Kadam-Yash-Sachin/Pick-and-Place-Arm-Designs/Design implementation images/first_prototype1.jpg

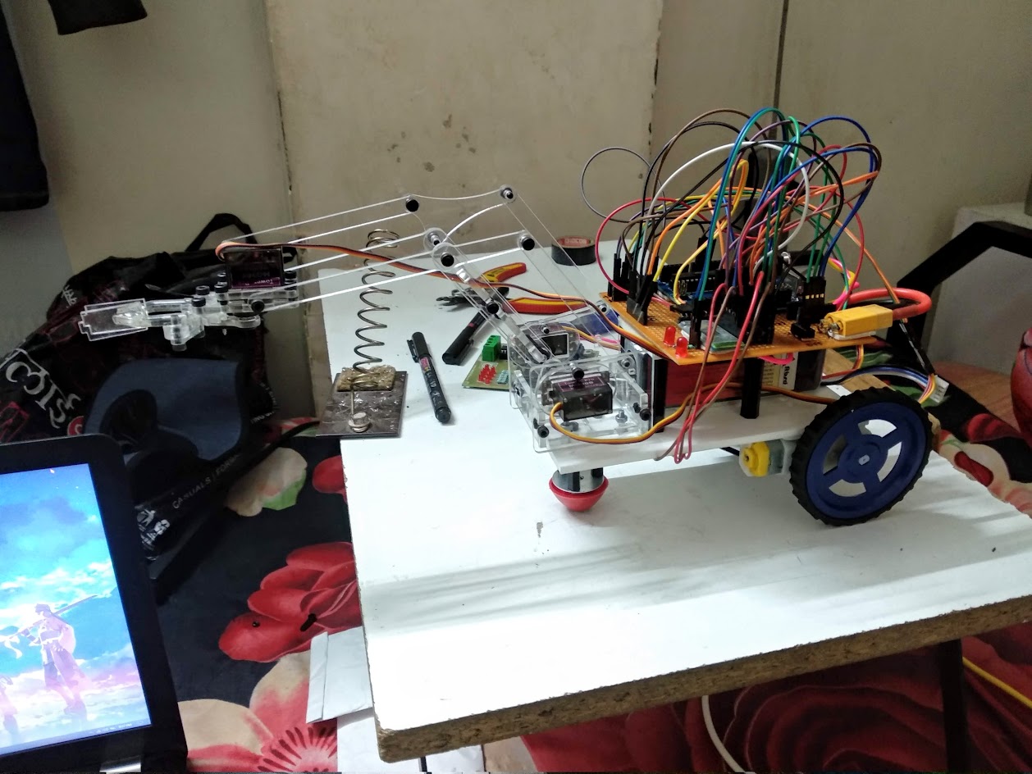
Design implementation images/first_prototype1.jpg
