Kadam-Yash-Sachin/Pick-and-Place-Arm-Designs/Design implementation images/first_prototype.jpg

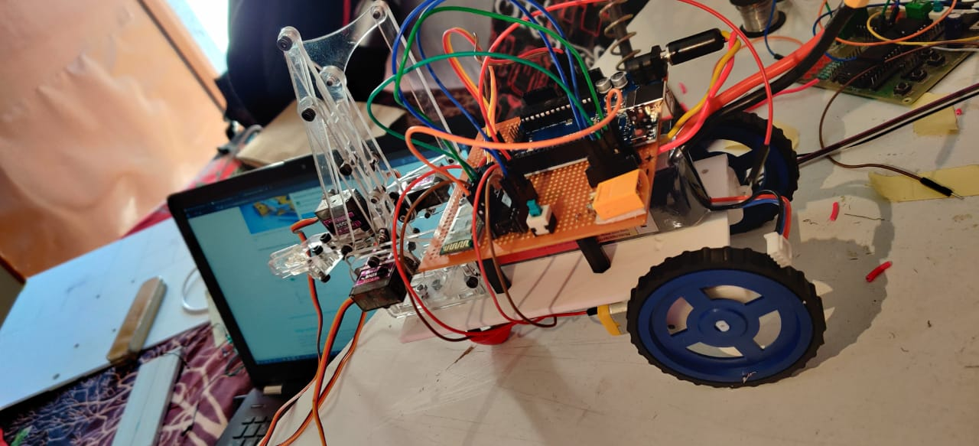
Design implementation images/first_prototype.jpg
