Kadam-Yash-Sachin/Pick-and-Place-Arm-Designs/README.md

# Pick-and-Place-Arm-Designs
Various Pick and Place arms were designed and implemented and were remotely controlled using Arduino and HC-05 Bluetooth Module
