Kadam-Yash-Sachin/Pick-and-Place-Arm-Designs/Design implementation images/Buck_converter_LTspice_sim_SS.jpg

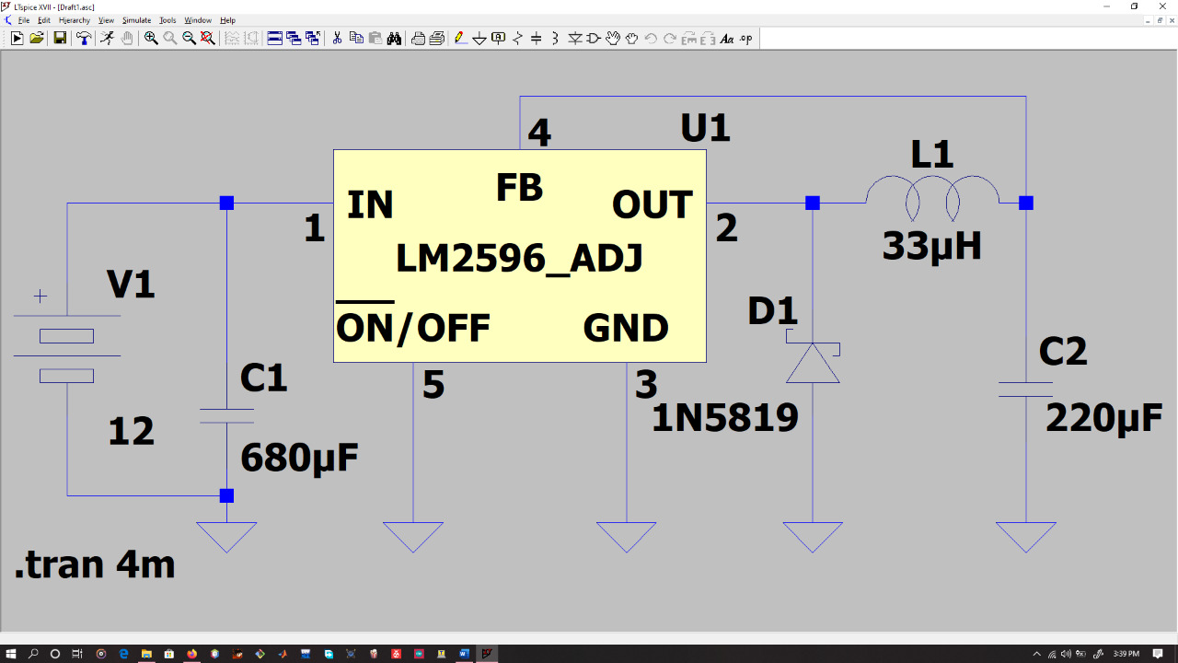
Design implementation images/Buck_converter_LTspice_sim_SS.jpg
