Kadam-Yash-Sachin/Pick-and-Place-Arm-Designs/Design implementation images/claw.jpg

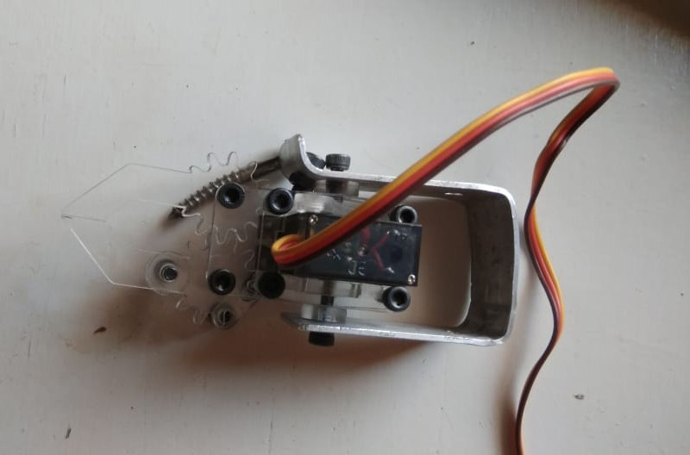
Design implementation images/claw.jpg
