Kadam-Yash-Sachin/Pick-and-Place-Arm-Designs/Design implementation images/first_design.jpg

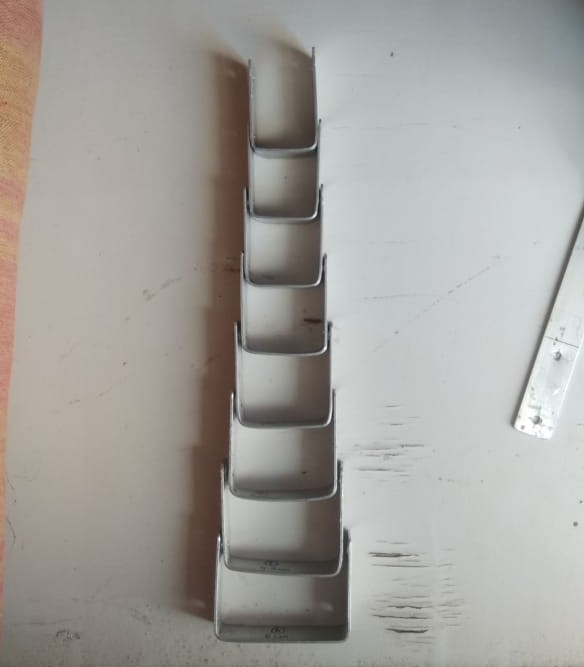
Design implementation images/first_design.jpg
