Kadam-Yash-Sachin/Pick-and-Place-Arm-Designs/Design implementation images/first_design_claw1.jpg

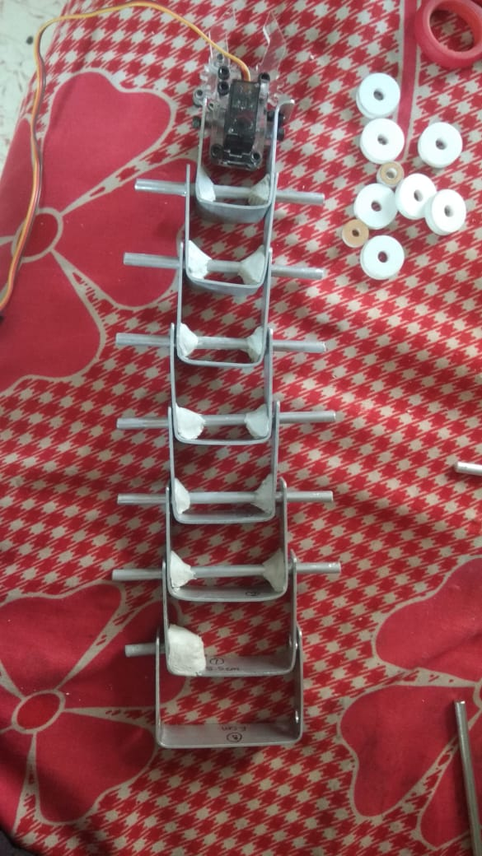
Design implementation images/first_design_claw1.jpg
