Kadam-Yash-Sachin/Pick-and-Place-Arm-Designs/Design implementation images/first_prototype2.jpg

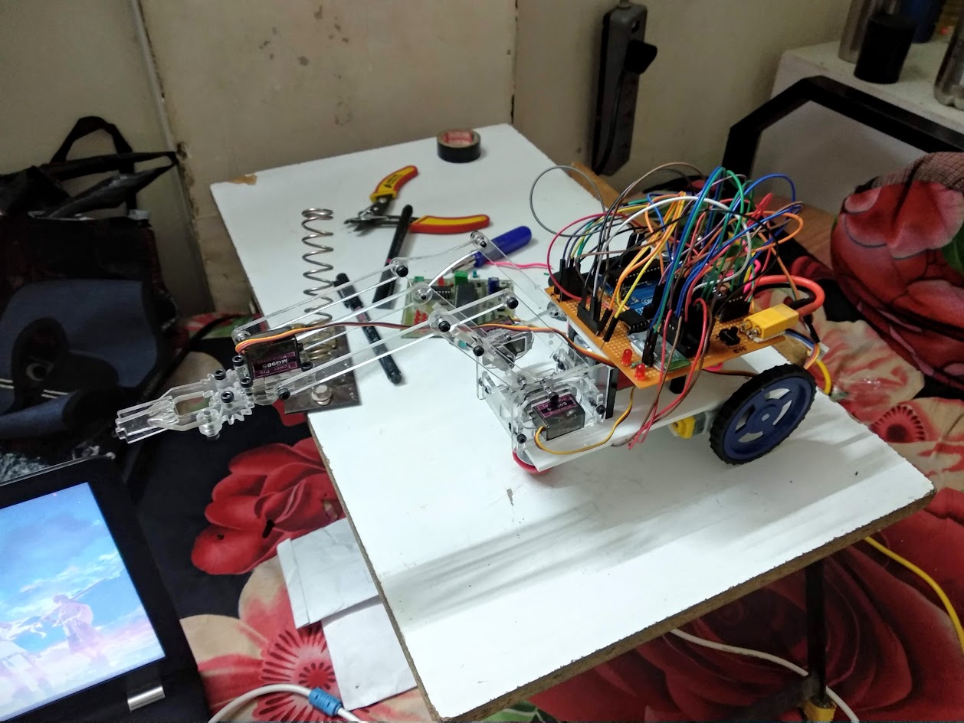
Design implementation images/first_prototype2.jpg
