Kadam-Yash-Sachin/Pick-and-Place-Arm-Designs/Design implementation images/Motion_control_proteus_sim_SS(1).png

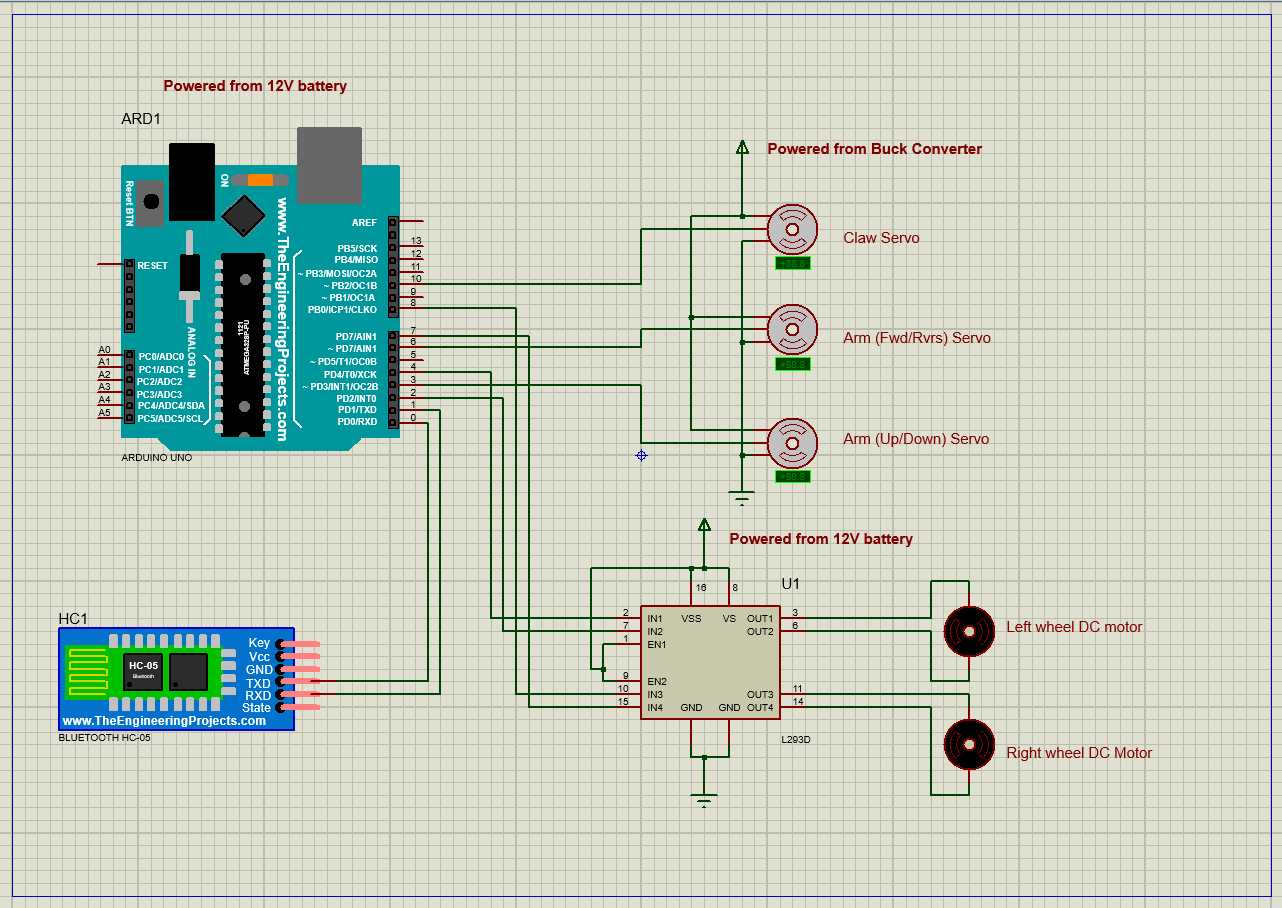
Design implementation images/Motion_control_proteus_sim_SS(1).png
