Kadam-Yash-Sachin/Pick-and-Place-Arm-Designs/Design implementation images/second_design.jpg

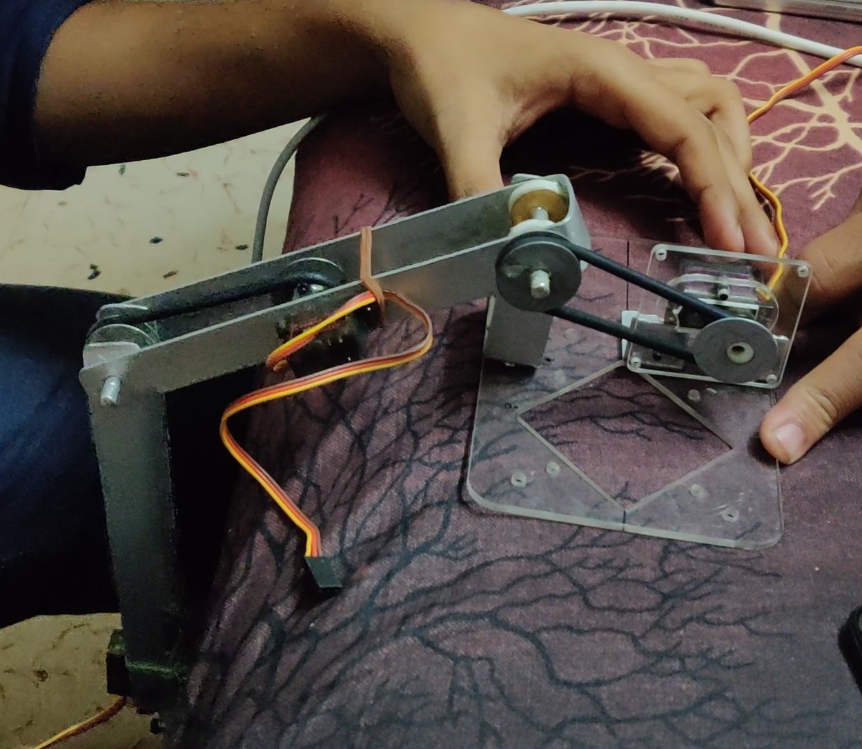
Design implementation images/second_design.jpg
