Kadam-Yash-Sachin/Pick-and-Place-Arm-Designs/first_prototype_.jpg

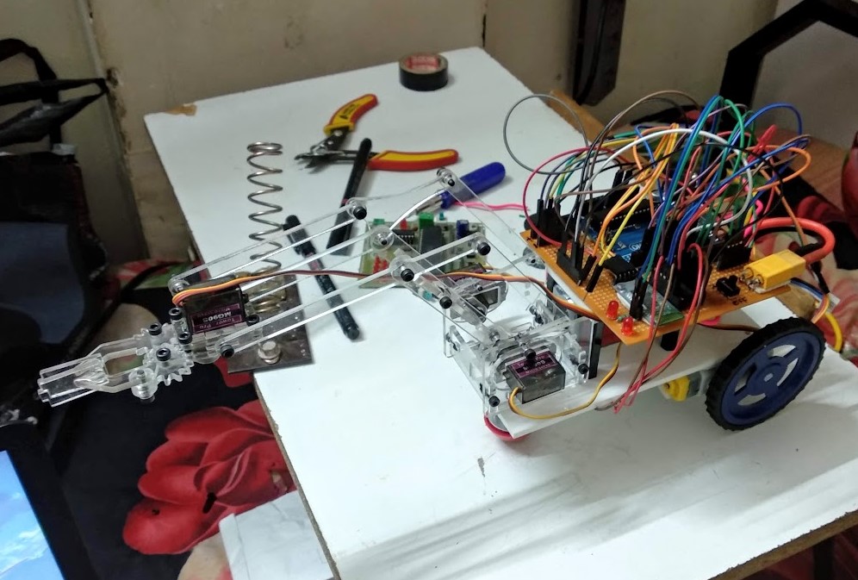
first_prototype_.jpg
