Kadam-Yash-Sachin/Pick-and-Place-Arm-Designs/Design implementation images/second_design_problem.jpg

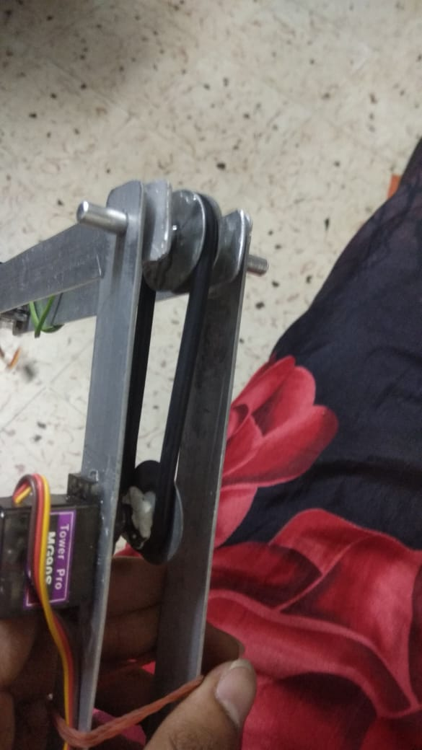
Design implementation images/second_design_problem.jpg
