Kadam-Yash-Sachin/Pick-and-Place-Arm-Designs/(list of files, drawings)

Other design files:
Proteus Simulations/ArduinoMega_Sim.pdsprj
Proteus Simulations/ESMP_Sim_Mega2560.pdsprj
Proteus Simulations/ESMPsim.pdsprj
