Kadam-Yash-Sachin/Pick-and-Place-Arm-Designs/Codes/RoboController/app/src/main/java/com/example/robocontroller/ledControl.java

package com.example.robocontroller;

import android.app.ProgressDialog;
import android.bluetooth.BluetoothAdapter;
import android.bluetooth.BluetoothDevice;
import android.bluetooth.BluetoothSocket;
import android.content.Intent;
import android.content.res.Configuration;
import android.content.res.Resources;
import android.os.AsyncTask;
import android.os.Bundle;
import android.view.View;
import android.widget.Button;
import android.widget.ImageButton;
import android.widget.Toast;

import androidx.appcompat.app.AppCompatActivity;

import java.io.IOException;
import java.util.UUID;

public class ledControl extends AppCompatActivity {
    Button forward,reverse,open,close,arm_up,arm_down;
    ImageButton up,down,left,right;
    Button stop,disconnected;

    String address = null;
    private ProgressDialog progress;
    BluetoothAdapter myBluetooth = null;
    BluetoothSocket btSocket = null;
    private boolean isBtConnected = false;
    static final UUID myUUID = UUID.fromString("00001101-0000-1000-8000-00805F9B34FB");
    Resources resources;

    @Override
    protected void onCreate(Bundle savedInstanceState) {
        super.onCreate(savedInstanceState);
        setContentView(R.layout.activity_led_control);

        up=findViewById(R.id.up);
        down=findViewById(R.id.down);
        left=findViewById(R.id.left);
        right=findViewById(R.id.right);
        forward=findViewById(R.id.arm_forward);
        reverse=findViewById(R.id.arm_reverse);
        arm_down=findViewById(R.id.arm_down);
        arm_up=findViewById(R.id.arm_up);
        open=findViewById(R.id.claw_open);
        close=findViewById(R.id.claw_close);
        stop=findViewById(R.id.stop);
        disconnected=findViewById(R.id.disconnect);

        resources=up.getResources();

        if (resources.getConfiguration().orientation == Configuration.ORIENTATION_PORTRAIT) {
            setContentView(R.layout.activity_led_control);
            //Toast.makeText(ledControl.this, " We are in portrait mode",Toast.LENGTH_SHORT).show();
        }else{
            setContentView(R.layout.activity_led_control_landscape);
            //Toast.makeText(ledControl.this, "We are in Landscape mode", Toast.LENGTH_SHORT).show();
        }


        Intent newint = getIntent();
        address = newint.getStringExtra("EXTRA_ADDRESS");

        disconnected.setOnClickListener(new View.OnClickListener() {
            @Override
            public void onClick(View v) {
                if (btSocket!=null) //If the btSocket is busy
                {
                    try
                    {
                        btSocket.close(); //close connection
                    }
                    catch (IOException e)
                    { msg("Error");}
                }
                finish(); //return to the first layout
            }
        });

        stop.setOnClickListener(new View.OnClickListener() {
            @Override
            public void onClick(View v) {
                if (btSocket!=null)
                {
                    try
                    {
                        btSocket.getOutputStream().write("STOP".getBytes());
                    }
                    catch (IOException e)
                    {
                        msg("Error");
                    }
                }
            }
        });

        up.setOnClickListener(new View.OnClickListener() {
            @Override
            public void onClick(View v) {
                if (btSocket!=null)
                {
                    try
                    {
                        btSocket.getOutputStream().write("FORWARD".getBytes());
                    }
                    catch (IOException e)
                    {
                        msg("Error");
                    }
                }
            }
        });

        down.setOnClickListener(new View.OnClickListener() {
            @Override
            public void onClick(View v) {
                if (btSocket!=null)
                {
                    try
                    {
                        btSocket.getOutputStream().write("REVERSE".getBytes());
                    }
                    catch (IOException e)
                    {
                        msg("Error");
                    }
                }
            }
        });

        left.setOnClickListener(new View.OnClickListener() {
            @Override
            public void onClick(View v) {
                if (btSocket!=null)
                {
                    try
                    {
                        btSocket.getOutputStream().write("LEFT".getBytes());
                    }
                    catch (IOException e)
                    {
                        msg("Error");
                    }
                }
            }
        });

        right.setOnClickListener(new View.OnClickListener() {
            @Override
            public void onClick(View v) {
                if (btSocket!=null)
                {
                    try
                    {
                        btSocket.getOutputStream().write("RIGHT".getBytes());
                    }
                    catch (IOException e)
                    {
                        msg("Error");
                    }
                }
            }
        });

        forward.setOnClickListener(new View.OnClickListener() {
            @Override
            public void onClick(View v) {
                if (btSocket!=null)
                {
                    try
                    {
                        btSocket.getOutputStream().write("ARM FORWARD".getBytes());
                    }
                    catch (IOException e)
                    {
                        msg("Error");
                    }
                }
            }
        });

        reverse.setOnClickListener(new View.OnClickListener() {
            @Override
            public void onClick(View v) {
                if (btSocket!=null)
                {
                    try
                    {
                        btSocket.getOutputStream().write("ARM REVERSE".getBytes());
                    }
                    catch (IOException e)
                    {
                        msg("Error");
                    }
                }
            }
        });

        arm_up.setOnClickListener(new View.OnClickListener() {
            @Override
            public void onClick(View v) {
                if (btSocket!=null)
                {
                    try
                    {
                        btSocket.getOutputStream().write("ARM UP".getBytes());
                    }
                    catch (IOException e)
                    {
                        msg("Error");
                    }
                }
            }
        });

        arm_down.setOnClickListener(new View.OnClickListener() {
            @Override
            public void onClick(View v) {
                if (btSocket!=null)
                {
                    try
                    {
                        btSocket.getOutputStream().write("ARM DOWN".getBytes());
                    }
                    catch (IOException e)
                    {
                        msg("Error");
                    }
                }
            }
        });

        open.setOnClickListener(new View.OnClickListener() {
            @Override
            public void onClick(View v) {
                if (btSocket!=null)
                {
                    try
                    {
                        btSocket.getOutputStream().write("OPEN CLAW".getBytes());
                    }
                    catch (IOException e)
                    {
                        msg("Error");
                    }
                }
            }
        });

        close.setOnClickListener(new View.OnClickListener() {
            @Override
            public void onClick(View v) {
                if (btSocket!=null)
                {
                    try
                    {
                        btSocket.getOutputStream().write("CLOSE CLAW".getBytes());
                    }
                    catch (IOException e)
                    {
                        msg("Error");
                    }
                }
            }
        });

    }

    private void msg(String s)
    {
        Toast.makeText(getApplicationContext(),s,Toast.LENGTH_LONG).show();
    }


    private class ConnectBT extends AsyncTask<Void, Void, Void>  // UI thread
    {
        private boolean ConnectSuccess = true; //if it's here, it's almost connected

        @Override
        protected void onPreExecute()
        {
            progress = ProgressDialog.show(ledControl.this, "Connecting...", "Please wait!!!");  //show a progress dialog
        }

        @Override
        protected Void doInBackground(Void... devices) //while the progress dialog is shown, the connection is done in background
        {
            try
            {
                if (btSocket == null || !isBtConnected)
                {
                    myBluetooth = BluetoothAdapter.getDefaultAdapter();//get the mobile bluetooth device
                    BluetoothDevice dispositivo = myBluetooth.getRemoteDevice(address);//connects to the device's address and checks if it's available
                    btSocket = dispositivo.createInsecureRfcommSocketToServiceRecord(myUUID);//create a RFCOMM (SPP) connection
                    BluetoothAdapter.getDefaultAdapter().cancelDiscovery();
                    btSocket.connect();//start connection
                }
            }
            catch (IOException e)
            {
                ConnectSuccess = false;//if the try failed, you can check the exception here
            }
            return null;
        }
        @Override
        protected void onPostExecute(Void result) //after the doInBackground, it checks if everything went fine
        {
            super.onPostExecute(result);

            if (!ConnectSuccess)
            {
                msg("Connection Failed. Is it a SPP Bluetooth? Try again.");
                finish();
            }
            else
            {
                msg("Connected.");
                isBtConnected = true;
            }
            progress.dismiss();
        }
    }
}
